toshalkumbhar8979-design/RISC-V-RV32IM-SoC-/sw/platform/include/ctype.c

int isprint(int c) { return (c >= 0x20 && c < 0x7f); }
int isspace(int c) { return (c==' '||c=='\t'||c=='\n'||c=='\r'||c=='\f'||c=='\v'); }
int isalpha(int c) { return ((c>='a'&&c<='z')||(c>='A'&&c<='Z')); }
int isdigit(int c) { return (c>='0'&&c<='9'); }
int isalnum(int c) { return isalpha(c)||isdigit(c); }
int isupper(int c) { return (c>='A'&&c<='Z'); }
int islower(int c) { return (c>='a'&&c<='z'); }
int toupper(int c) { return (c>='a'&&c<='z') ? c-32 : c; }
int tolower(int c) { return (c>='A'&&c<='Z') ? c+32 : c; }
