toshalkumbhar8979-design/RISC-V-RV32IM-SoC-/sw/platform/include/limits.h

// limits.h — minimal freestanding (32-bit int, RV32)
#define CHAR_BIT 8
#define INT8_MIN (-128)
#define INT8_MAX 127
#define UINT8_MAX 255
#define INT16_MIN (-32768)
#define INT16_MAX 32767
#define UINT16_MAX 65535
#define INT32_MIN (-2147483647-1)
#define INT32_MAX 2147483647
#define UINT32_MAX 4294967295u
#define INT_MAX INT32_MAX
#define INT_MIN INT32_MIN
#define LONG_MAX 2147483647L
#define LONG_MIN (-2147483647L-1)
#define ULONG_MAX 4294967295uL
#define UINT_MAX UINT32_MAX#define SHRT_MIN (-32768)
#define SHRT_MAX 32767
#define USHRT_MAX 65535
