toshalkumbhar8979-design/RISC-V-RV32IM-SoC-/sw/platform/include/math.h

// math.h — minimal freestanding (stubs in riscvsoc_stubs.c)
double sqrt(double);
double sin(double);
double cos(double);
double atan2(double, double);
double pow(double, double);
double floor(double);
double fabs(double);
float sqrtf(float);
float fabsf(float);
