toshalkumbhar8979-design/RISC-V-RV32IM-SoC-/sw/platform/include/string.h

// string.h — minimal freestanding (stubs in riscvsoc_stubs.c)
typedef unsigned long size_t;
#define NULL ((void*)0)
void *memset(void*, int, size_t);
void *memcpy(void*, const void*, size_t);
void *memmove(void*, const void*, size_t);
int memcmp(const void*, const void*, size_t);
void *memchr(const void*, int, size_t);
size_t strlen(const char*);
char *strcpy(char*, const char*);
char *strncpy(char*, const char*, size_t);
int strcmp(const char*, const char*);
int strncmp(const char*, const char*, size_t);
char *strcat(char*, const char*);
char *strncat(char*, const char*, size_t);
char *strchr(const char*, int);
char *strrchr(const char*, int);
char *strstr(const char*, const char*);
char *strtok_r(char*, const char*, char**);
char *strdup(const char*);
