toshalkumbhar8979-design/RISC-V-RV32IM-SoC-/(commit log)

2026-08-19 Phase 2 WIP: SoC top + bootrom + SRAM + QSPI + SPI-TFT + UART + timer; QSPI read path data-verified on one transaction; model re-sync open
2026-08-19 Phase 2 COMPLETE: SoC end-to-end PASS (flash boot copy, display DE AD BE EF, timer IRQ handled)
2026-08-19 Phase-2 polish: make soc/qspi targets, TB sink init fixes, TFT unit test
    [_tb_tft.v]
2026-08-19 Phase 4: ECP5 tooling + scripts installed; honest blocker doc (async-SRAM->BRAM refactor) and no-board validation statement
2026-08-19 ph5: stage OpenLane2 sign-off probe after env blocker (libparse/py3.13, ghcr auth); report + config + runners
2026-08-20 ph5: validated probe (Yosys0.65 elab: 33.1k cells), canonical v2 config, self-contained RTL snapshot, correct image tag 2.3.10; pull restarted; honest status
    [bootrom.v, qspi_ctrl.v, riscv_doom_soc.v, riscv_soc.v, rv32_alu.v, rv32_core.v, rv32_csr.v, rv32_decoder.v]
2026-08-21 ph5: full RTL->GDS-II sign-off (probe) — flow complete, DRC/LVS/timing clean (0 err, 0 diff, setup+8.8ns); archive metrics+paper(PDF), run scripts, report
2026-08-21 ph5: add consolidated master PDF (RISCV_SOC_MASTER.pdf, 8 pages) — cover+TOC+architecture+phases0-4+conference paper+phase5 signoff+metrics+refs; generators
2026-08-22 docs: add Visuals/screenshots section (die views + waveform slots) to README
2026-08-22 Update README with HTML image tags for die views
    Replaced image links with HTML img tags for die views in README.
2026-08-26 feat(periph): add SPI-TFT pixel-DMA engine (framebuffer->ILI9341); unit-verified (TFT_DMA: OK)
2026-08-26 feat: OpenRAM macro wrapper+plan, DOOM glue scaffold, pad-ring/Cadence plans; 25ns corner run completes (SS setup -0.07ns, DRC/LVS clean)
2026-08-27 feat(sw): DOOM engine integration — full DG_* platform, freestanding libc stubs (250+ lines), 16 freestanding headers, build/link scripts; engine compiles for RV32IM (61+ .o files)
2026-08-27 docs: rewrite README in first person — project narrative, results, visuals, next steps
2026-08-27 feat(sw): DOOM engine compiles for RV32IM (79/79 files, 0 errors) — link requires multi-region linker (code in flash, heap in PSRAM 8MB) since 32KB on-die SRAM insufficient; documented
    [doom_main.c, errno.h, platform.c, riscvsoc_stubs.c, stdio.h, unistd.h]
2026-08-27 feat(sw): DOOM engine LINKED for RV32IM — 615KB (text 311K + data 60K + bss 244K), multi-region linker (flash XIP + PSRAM heap + SRAM stack); 79/79 files compiled + linked + binary produced
